ACM32-MCU/electric-toothbrush/软件设计/readme.txt

IDE版本：	KEIL5.31
注意事项：本工程中使能了QMI8658C。蓝牙5.0对数据传输过程的数据长度有要求，为避免数据丢失使用固定长度的模拟惯性数据。此问题尚未完善。
