ACM32-MCU/electric-toothbrush/(commit log)

2022-02-09 初始版本提交
2022-02-09 修改gitignore文件导致的文件多余及文件缺失的问题
2022-05-27 新增README.md文件
